voidrot/3d-designs/(list of files, cad)

Other CAD files:
10.1-ESP-Touchscreen-Frame/CrowPanelCase_proto.FCStd
10.1-ESP-Touchscreen-Frame/exports/crowpanel_back_shell.stl
10.1-ESP-Touchscreen-Frame/ESP32-P4-10_1-inch-20251230.stp
10.1-ESP-Touchscreen-Frame/exports/crowpanel_bezel_text.stl
10.1-ESP-Touchscreen-Frame/exports/crowpanel_cradle.stl
10.1-ESP-Touchscreen-Frame/exports/crowpanel_bezel.stl
