voidrot/3d-designs/(commit log)

2026-10-04 Initial commit: FreeCAD design repo with CrowPanel 10.1" desk case
    - 10.1-ESP-Touchscreen-Frame: parametric case generator, plan, renders, STL exports
    - Archive: earlier ELCROW frame and enclosure iterations
    - README, CLAUDE.md, .gitignore, FreeCAD MCP config
    [Bezel_Left.stl, Bezel_Right.stl, Cradle_Crossbar.stl, Cradle_Left.stl, Cradle_Right.stl, CrowPanelCase_proto.FCStd, ELCROW_10_1_Dev_Frame_FirstFit.FCStd, ELCROW_10_1_Dev_Frame_FirstFit_V2.FCStd]
2026-10-05 Move GPIO header opening up 3 mm to center it over the board
    [CrowPanelCase_proto.FCStd, crowpanel_back_shell.stl]
2026-10-18 chore: cleanup archive
    [Bezel_Left.stl, Bezel_Right.stl, Cradle_Crossbar.stl, Cradle_Left.stl, Cradle_Right.stl, ELCROW_10_1_Dev_Frame_FirstFit.FCStd, ELCROW_10_1_Dev_Frame_FirstFit_V2.FCStd, ELCROW_10_1_Dev_Frame_FirstFit_V4_PUBLISHED_20260920_0240.FCStd]
2026-10-18 docs: rewrite README for people printing and assembling the parts
